drossato/arduino-sousvide/board/place.pdf

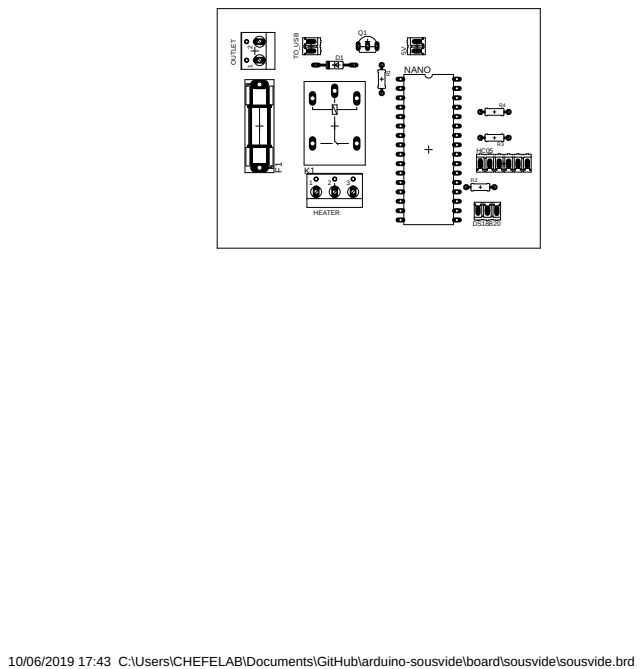
[picture p1: page 1]
NANO; R4 TO_USB; HEATER OUTLET

10/06/2019 17:43 C:\Users\CHEFELAB\Documents\GitHub\arduino-sousvide\board\sousvide\sousvide.brd
