drossato/arduino-sousvide/board/sousvide.pdf

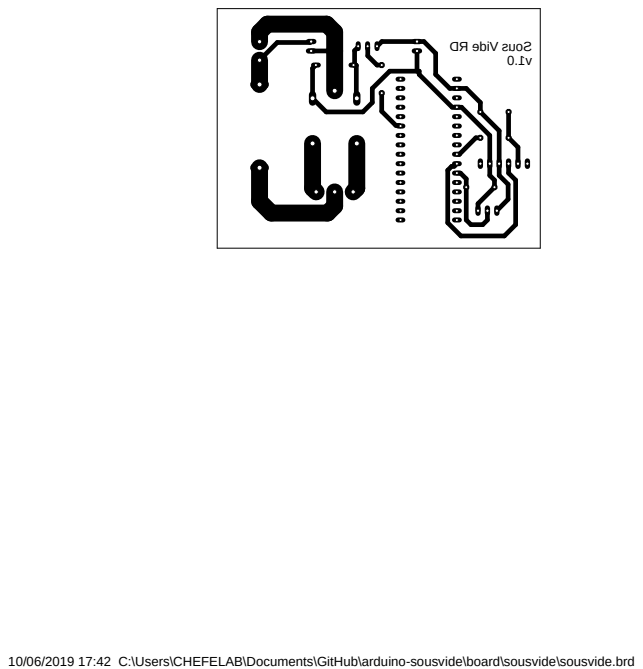
[picture p2: page 1]

10/06/2019 17:42 C:\Users\CHEFELAB\Documents\GitHub\arduino-sousvide\board\sousvide\sousvide.brd
