drossato/arduino-sousvide/board/sousvide/sousvide.brd

## EAGLE design board/sousvide/sousvide.brd (2019-06-12)

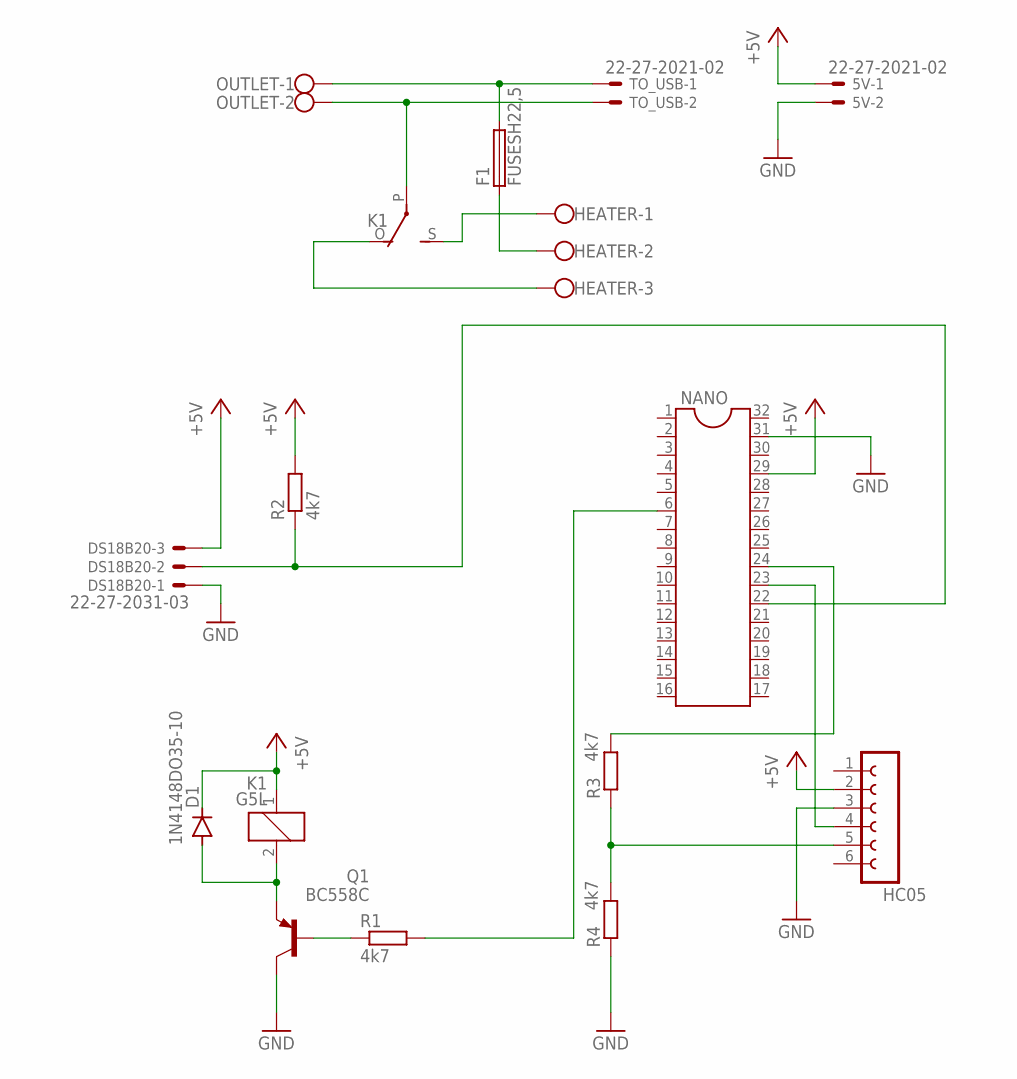
[picture p3: schematic sousvide.sch]

Parts:
5V: 22-27-2021-02; 6410-02
D1: 1N4148DO35-10; DO35-10
DS18B20: 22-27-2031-03; 6410-03
F1: FUSESH22,5; SH22,5
HC05: FE06-1; FE06
HEATER: W237-103
K1: G5L; G5LE
NANO: DIL32
OUTLET: W237-102
Q1: BC558C; TO92-EBC
R1, R2, R3, R4: 4k7; 0204/7
TO_USB: 22-27-2021-02; 6410-02

Connections:
+5V: 5V.1, D1.C, DS18B20.3, HC05.2, K1.1, NANO.29, R2.2
BTRX: HC05.5, R3.1, R4.2
GND: 5V.2, DS18B20.1, HC05.3, NANO.31, Q1.C, R4.1
unnamed: F1.2, OUTLET.1, TO_USB.1
unnamed: K1.P, OUTLET.2, TO_USB.2
unnamed: D1.A, K1.2, Q1.E
unnamed: Q1.B, R1.1
unnamed: F1.1, HEATER.2
NANORX: HC05.4, NANO.23
NANOTX: NANO.24, R3.2
ONEWIRE: DS18B20.2, NANO.22, R2.1
RELAYCONTROL: NANO.6, R1.2
RELAYNA: HEATER.1, K1.S
RELAYNC: HEATER.3, K1.O

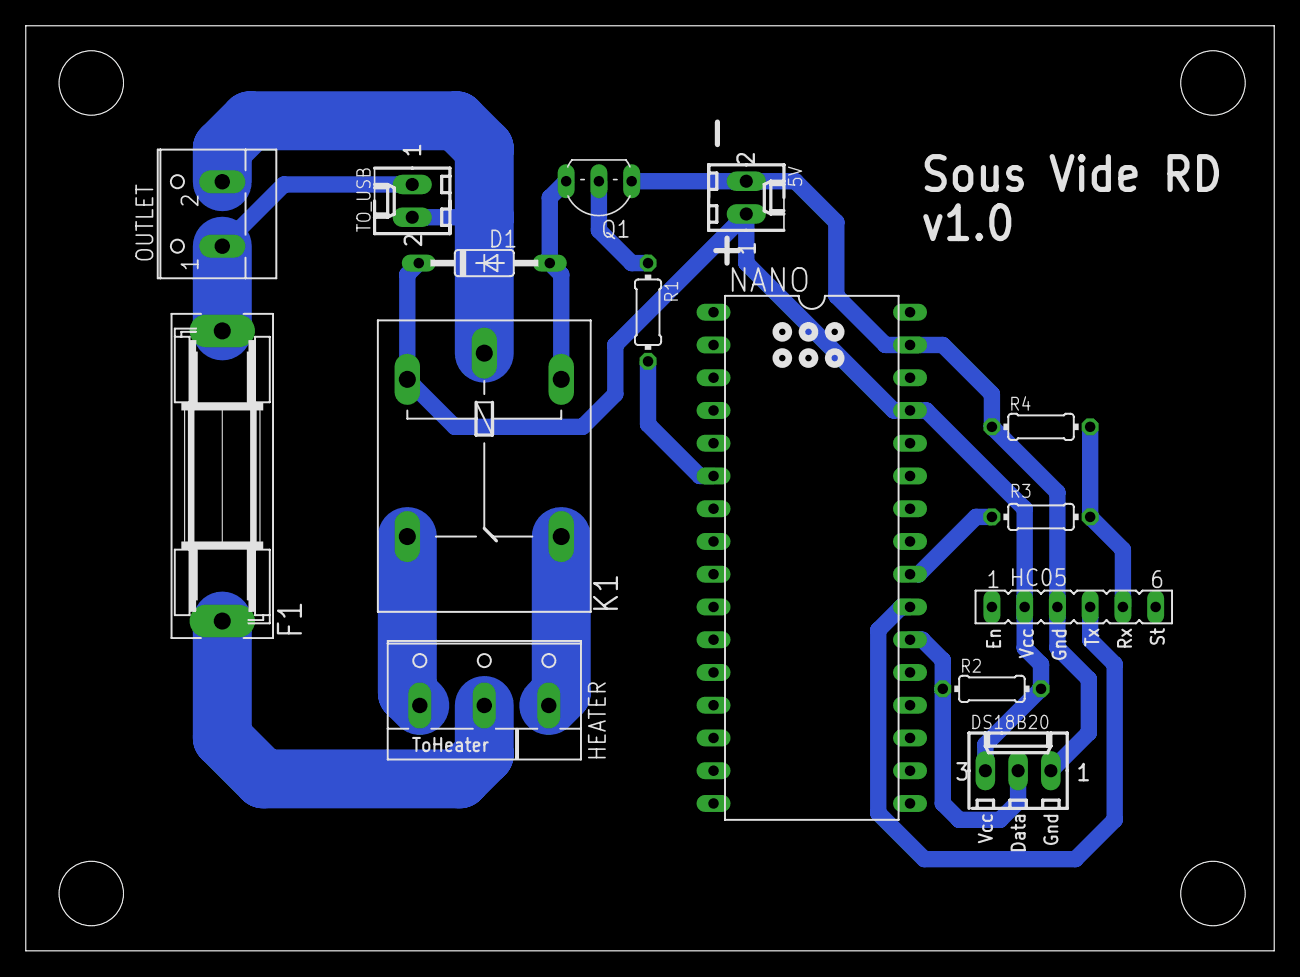
[picture p4: board sousvide.brd from above]

Board: 2 copper layers, 96.8 x 71.7 mm, 15 parts (0 on the bottom side), 14 nets.
