drossato/arduino-sousvide/(commit log)

2019-05-29 Main file added
    Adding main file. Control functionality is complete, albeit with a hard-coded fixed setpoint.
    [sousvide.ino]
2019-06-04 Correction in measurements
    Now does not increase measure counter if the measurement was invalid
    [sousvide.ino]
2019-06-04 Relay safety and PID delay
    - No more 30s delay between turning on and PID starting
    - Relay now switches off if communication with temperature sensor is lost
2019-06-07 Sous Vide PCB Added
    Made using Autodesk EAGLE 9
    [sousvide.brd, sousvide.sch]
2019-06-07 Create BOM.txt
    BOM for 2 boards
2019-06-10 Board change
    Changed design so the BT module can fit over the board
    [sousvide.brd, sousvide.sch]
2019-06-10 New fuse
    Updating fuse holder footprint to match the one we bought
    [sousvide.brd, sousvide.sch]
2019-06-11 Board corrections
    Changed relay transistor to PNP, to avoid turning the heater on during reset and with the device turned off.
    Changed transistor base resistor to 4k7. Old value did not allowed enough current to switch the relay.
    [sousvide.brd, sousvide.sch]
2019-06-11 Updated pins
    Changed pins in the arduino code to match the new board. Added Bluetooth.
2019-06-12 Connectors update
    Changing connectors to better match physical ones. Created better labels in silk layer.
    [sousvide.brd, sousvide.sch]
2019-06-18 Update code for PNP
    Updating code to match the PNP transistor used in the board to drive current to the relay. Old version was NPN.
2019-06-24 Integral Windup
    New integral windup strategies implemented in the PID controller, based on https://ieeexplore.ieee.org/stamp/stamp.jsp?tp=&arnumber=1193605
    Default is set as back-calculation, alternative is clamping. Needs tests and recalibration.
2019-06-25 PID update
    Changed windup to clamping, and updated the gains.
2020-03-28 Report
    Added the "R" command, that responds with a report containing, temperature, setpoint, state, sensor function, uptime.
2022-06-08 Report and reset resume
    - Auto continuation after unintended short reset
    - New command - R (report) - show more information like setpoint and uptime.
    [sousvide.ino]
2022-06-09 Sensor Resolution Change
    Newer sensors have been slower, so the resolution has been lowered to compensate.
